Yvonne202202/MSc-Advanced-Project-Blog/README.md

# MSc Advanced Project Blog -The Clock of Life
<div align=center>
  
</div>

# Video Link：
https://vimeo.com/887942953?share=copy

## Project Brief
I once had a discussion the topic of death with my friends. Most of us feel some kind of fear when talk about death. This stems not only from the fear of the end of one's own life, but also from the pain of losing those close to them. Death often carries a heavy burden on people, so many people choose to avoid this sensitive topic, which also makes them feel helpless when they actually face death.

Therefore, I planned to do an interactive installation on the theme of "life and death," which would include some physics experiments. I hope viewers will come to a different understanding and thinking about death through this interactive installation.

## Ideation
### Research
Human's concept of life and death varies due to cultural, religious and other reasons.  Therefore, I think I need to understand people's views on death from a different perspective before I start the project.

People's perceptions of death are often influenced by their religious beliefs. Those with higher levels of religious belief had lower levels of death anxiety. They accept death in a more neutral way. In contrast, people with no religious affiliation were more likely to have death anxiety and positive attitudes about extending life.

In addition, the degree of death anxiety is also related to different regional cultures.

There are some taboos about death in East Asian cultures. For example, people sometimes avoid talking about death, especially on celebratory occasions. In addition, for traditional East Asians, especially Chinese, the same pronunciation as "death" is considered unlucky. For example, the word for the number "4" and "clock" in Chinese is pronounced the same as "death", so people should not give clocks or watches as gifts, and should also avoid giving things with a number of 4. Although many younger generations of East Asians are more open to these traditional taboos, the influence of such traditional thinking persists.

There are different attitudes towards death, even if there are certain differences among people from different cultural backgrounds, there are still some common points.
In every culture people mourn the dead. In a sense, people respect death, which is also a respect for life.

The famous philosopher Nietzsche once proposed "eternal reincarnation". He believed that the lives of dead individuals would reappear countless times in infinite time. The famous ancient Chinese philosopher Zhuangzi believed that death is another form of life, not the end of life, but the beginning of life.

In addition to discussing personal death, the death of someone close to you is also worth exploring in depth. In my research, I found that the death of a family member or friend is more difficult for many people to accept than their own death. They tend to avoid thinking about it, which caused some difficulties during my research. In order to clarify the research direction, I interviewed several participants. For one questionnaire, I designed a scenario: if a relative or friend is seriously ill and needs rescue, and the doctor tells the patient that he or she may not be able to live a normal life or even enter a vegetative state after rescue, will they still choose to continue rescue? Most respondents said it would be difficult for them to decide to give up on saving their loved ones unless the patient had previously made it clear that they did not want to be saved, even if the patient could still suffer. One interviewee even told me that she was afraid to face such a question. She didn't want to think about such a difficult choice ahead of time, which made it impossible for her to continue discussing the topic with me.

In the face of the death of another, people often suddenly experience a great sense of loss, which is difficult to accept and let go. After the loss of a loved one, it takes a long time for us to adjust and accept the loss. And, even after a long time has passed, we may not be able to fully let go. Certain scenes or things touch our heartstrings and remind us of them at certain moments, which make us ache and miss them. Therefore, how to achieve emotional relief is an important and in-depth issue.

I intend to explore life and death from a philosophical perspective through an interactive installation, and I will consider how to incorporate the sense of "finding closure" regarding the passing of a loved one.

In my work, I would like to show life and death as a never-ending cycle. "Life" is the beginning of the cycle, while "death" signifies its conclusion. However, with every ending comes a new beginning, and the chain of life continues.

### Concept Development

After conceptualizing the concept of the "circle of life," I encountered the challenge of how to concretize this "circle." I need to find a way to interact and engage the audience. Furthermore, I aim for this work to reach the viewers.

Under the suggestion from my supervisor Jen, I experimented with several different types of sensors and found some inspiration by studying the work of other artists. And I went to several material shops to explore if there was anything I could use.

I saw tools for making clocks for children in a shop, and it made me realize that I might be able to make a clock. The time on the clock is 0 o 'clock to 23:59 day after day, which is so similar to the cycle of life. What's more, "clock" sounds similar to the Chinese word "death", which has some symbolic meaning.

However, this clock needs to be different from a regular clock. I think it needs to be able to show the audience the process of life from birth to death, and then from death to birth again. And the interaction between the audience and the interactive installation is critical. The audience is in a sense part of this interactive installation that triggers the “circle of life”.

I considered creating a simulated heart on which the audience can perform CPR. This act initiates the “Circle of Life”, and each CPR attempt by the viewer is like a desperate bid to save a life.   However, all life has its endpoint, marking the inevitable completion of the circle of life. This conclusion does not signify the ultimate end, as every end heralds a new beginning. The intervals on the clock's dial can gradually decrease, simulating the journey towards “death”. At the inception of the “Circle of Life”, it is relatively easier for the audience to save this “life”. But as the hands of the clock edge closer to the endpoint, it races rapidly towards zero, symbolizing the inevitable and the futility in trying to rescue the “life”.

<div align=center>
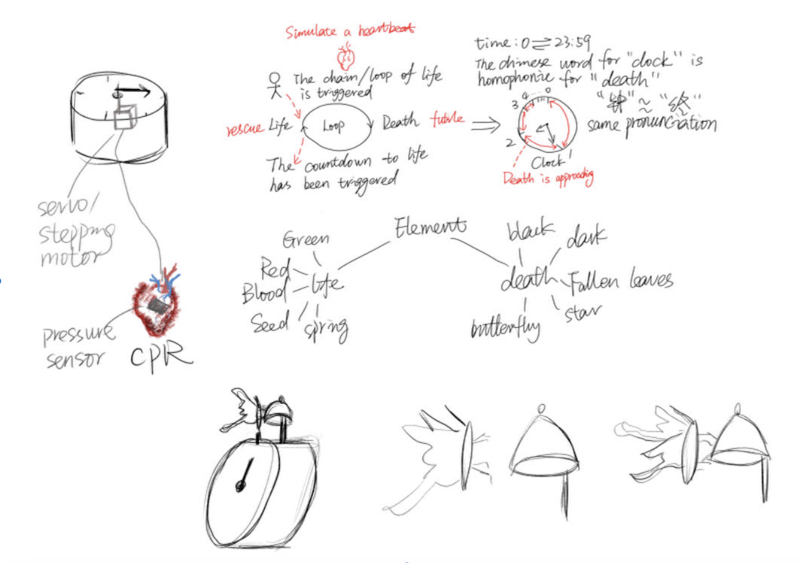
[picture p1: images/3.jpg]
  
</div>

However, the detailed design of the clock requires deeper consideration. In my initial search for inspiration, I considered elements that could symbolize life and death. To depict life, I thought of using vibrant green and red, with green representing life and red symbolizing blood. For representing death, I considered using black, dark tones, fallen leaves, stars, and butterflies.

<div align=center>
  
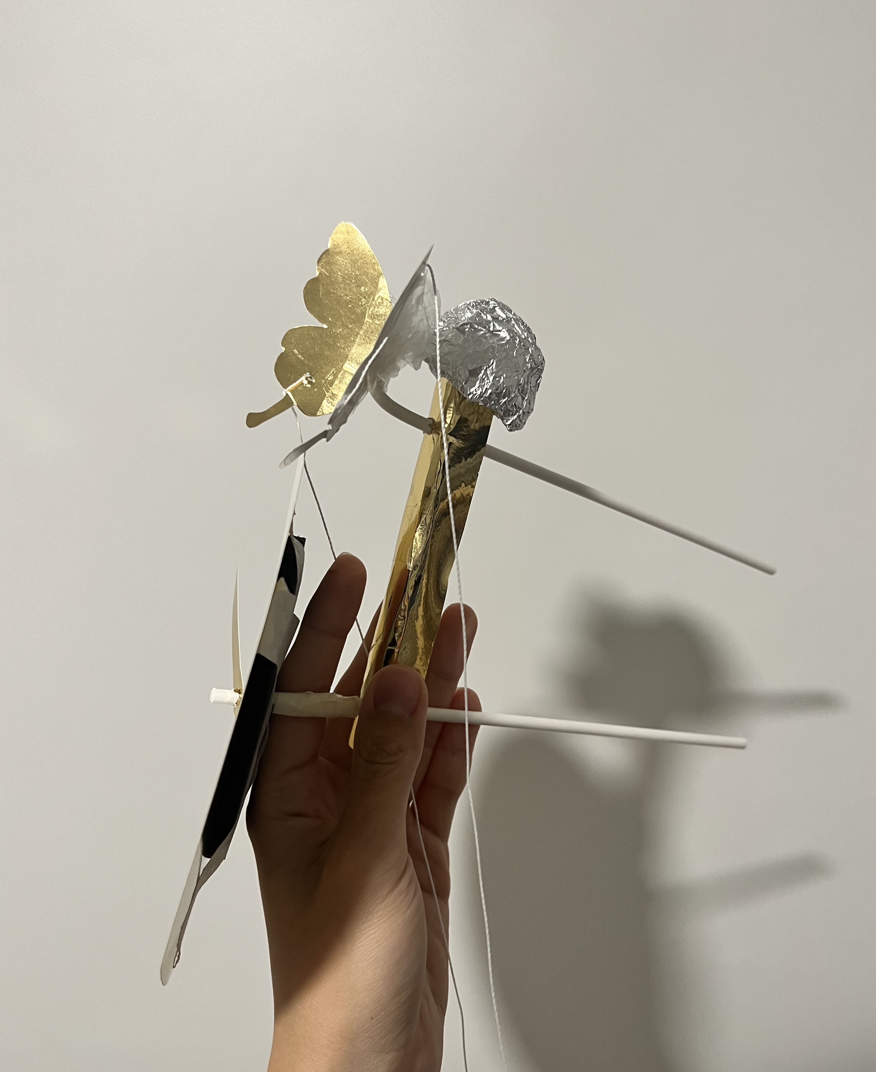
[picture p2: images/13.jpg]
  
</div>

For the first version of the prototype, I came up with the idea of using a mechanical butterfly as the bell of this clock, which rings the bell when time returns to zero. But after discussing it with Jen, my supervisor, I realized that I should focus more on the design of the clock face than the rest of it.

While designing the clock face, I came across some interesting materials while seeking inspiration. A paper-cut artwork captivated me.   Its creator had carved doves' shape from thick cardboard and took it outdoors, providing a unique view of the natural scenery through the cut-out shapes. Another source of inspiration was a drawing from the book 'The Ecological Relations of Roots' by John Ernest Weaver (1919), which illustrates a plant's root system but reminded me of human blood vessels.   This sparked an idea to merge the pattern of blood vessels with hollow carving, allowing viewers to observe life's pulsations through the "blood vessels". Similarly, this design could also represent tree roots, as both roots and blood vessels are symbols of life.

<div align=center>
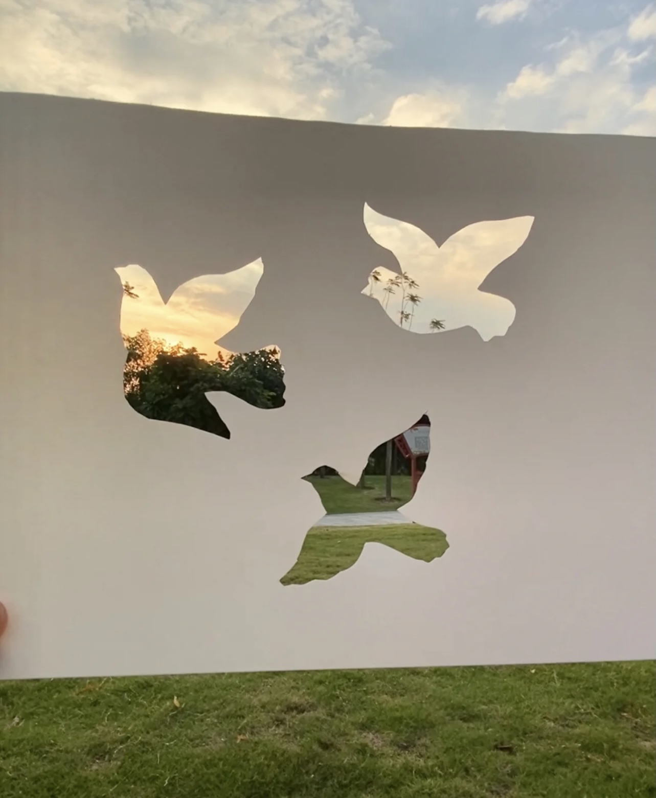
[picture p3: images/10.jpg]
  
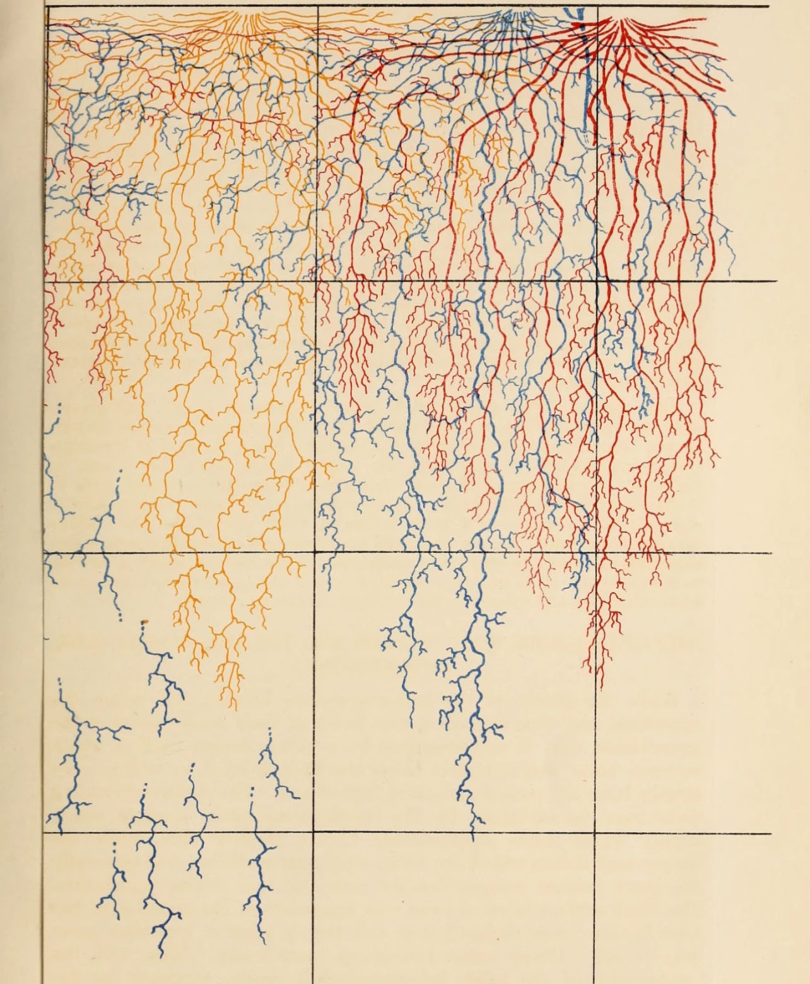
[picture p4: images/12.jpg]
  
</div>

I plan to make a clock face made of three superimposed coaxial discs. The topmost disc is transparent, engraved with time scales and remaining fixed. The second disc layer is made of opaque material with a blood vessel cutout design, allowing one to see through to the third layer. The bottom disc is made of colorful materials, representing life. I imagine that the second and third discs could be rotated according to the audience's interaction, such as through a heart rate sensor that detects the audience's heart rates and displays varying patterns based on the different readings.

<div align=center>
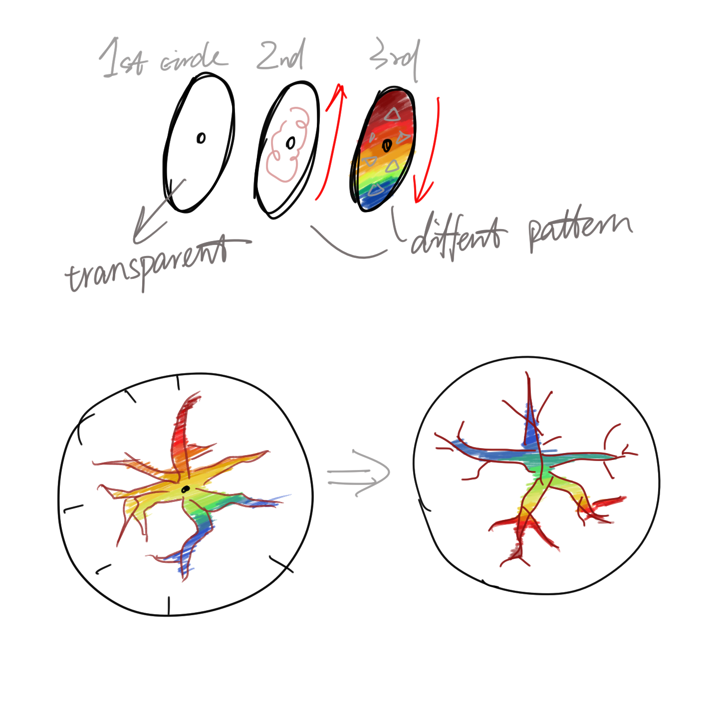
[picture p5: images/15.png]
  
</div>

<div align=center>
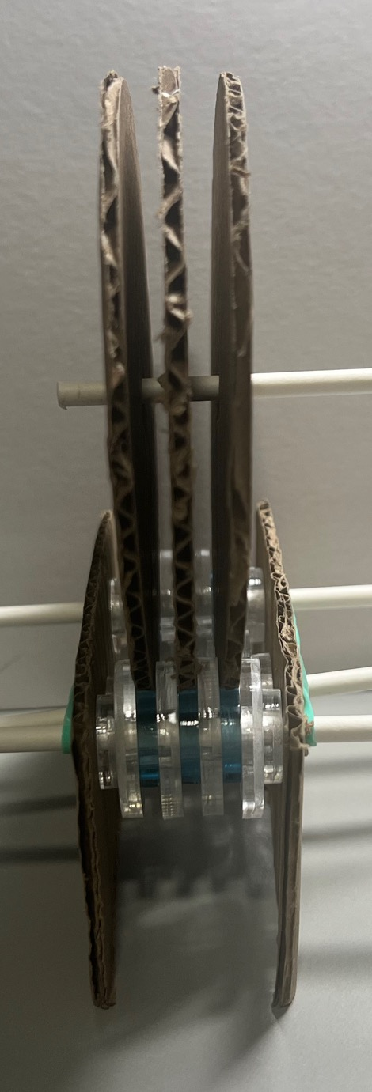
[picture p6: images/7.jpg]
  
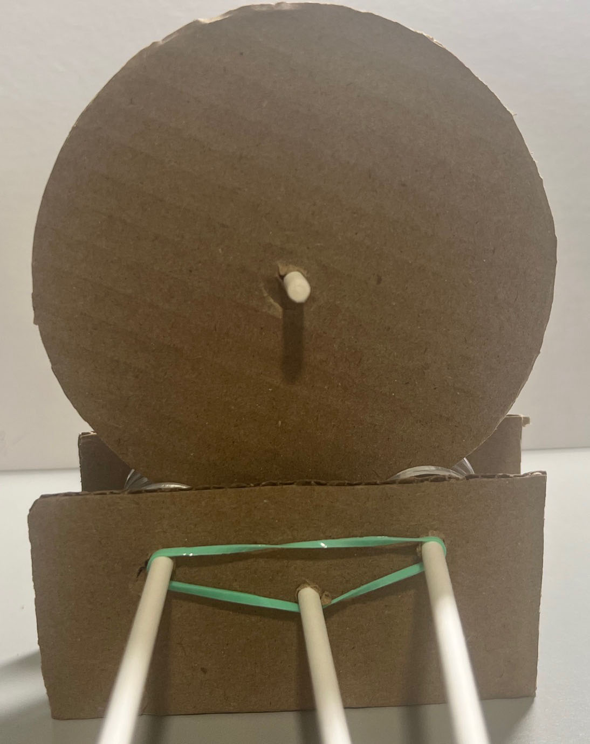
[picture p7: images/20.jpg]
  
</div>

### Determine Design Objectives

<div align=center>
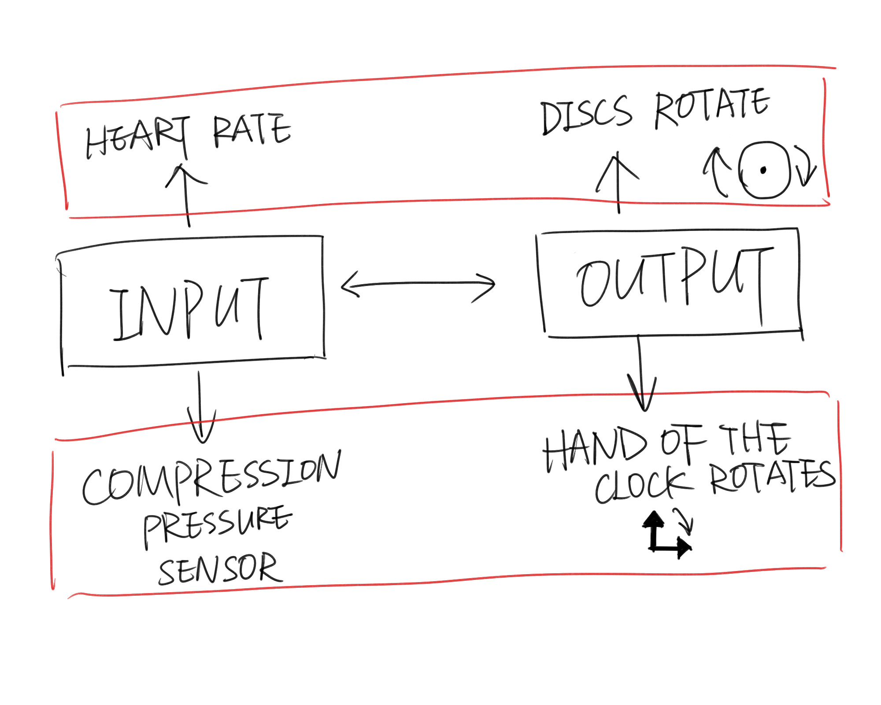
[picture p8: images/16.jpg]
  
</div>

My goal is to control two outputs with two inputs. The first input is the heart rate sensor. The sensor will be connected to the experiencer's finger, and when the sensor recognizes the different heart rates of different experiencers, it will control the rotation of the clock face disc, resulting in different heart rate patterns. The other sensor is the compression pressure sensor. It will be placed in a simulated heart, and the experiencer could perform "CPR" to control the rotation of the clock hand.

<div align=center>
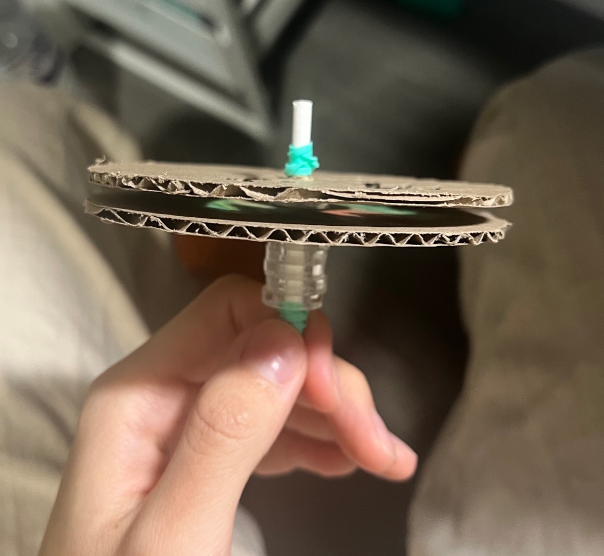
[picture p9: images/34.jpg]
  
</div>

My second prototype was made of three discs that were placed upright. I found it difficult to control the rotation of the three disks during the test. And I was planning to use acrylic as the material for my clock face. I think the load bearing and structure are also problems. After a round of iterations, I got my third version of the prototype. With this version in mind for load-bearing issues, I have removed the top disc from the previous version. And I considered placing the other two horizontally. After experimenting, I thought this version could be achieved.

I was going to use the compression pressure sensor to control the top clock face with blood vessel cutout design and the heart rate sensor to control the patterned bottom clock face.  The top clock face needs to reflect the passing of life to the experiencer.  So the effect I would like to achieve is that when the experiencer begins to "save" this "life", it is easy to move to the next scale, and gradually becomes more difficult.  So I want to control the twelve intervals of the clock of life to get smaller and smaller.  Therefore, I considered using a stepper motor to control the rotation Angle of the top clock face.  Due to the weight of the two layers of acrylic sheets, I considered using a DC motor with high torque to control the underlying clock face.

## Experimentation
### Test - Stepper Motor

<div align=center>
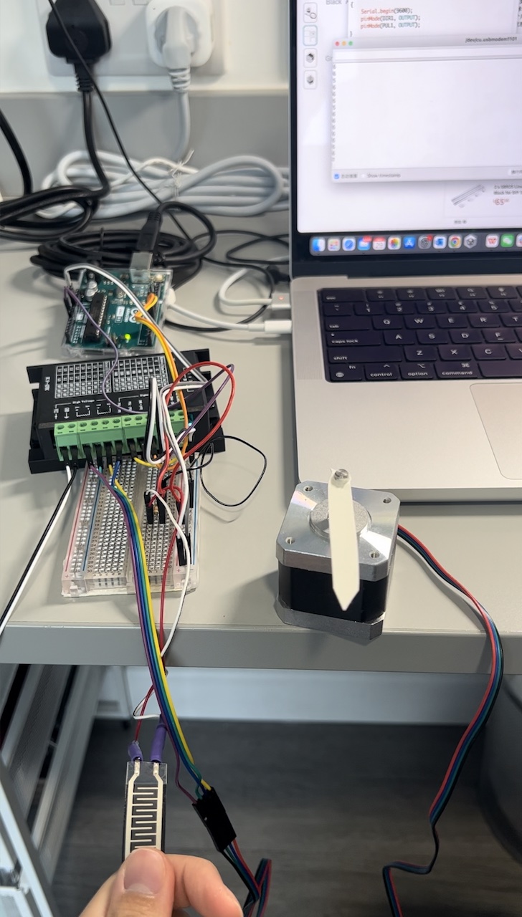
[picture p10: images/25.jpg]
  
</div>
The Arduino UNO board is used to read the status of the  compression pressure sensor. I have set the stepper motor's rotation angles to 95, 60, 45, 35, 30, 25, 20, 15, 12, 10, 8, and 5 degrees, and stored them in the array Step. I use a flag and the pressure reading together as the judgment conditions. If the pressure is greater than 1 and the flag is set to true, the stepper motor is activated and operates according to the corresponding number of steps in the array Step, until the pressure is released and no longer applied. When the count exceeds 12, it is reset to 1, thereby cycling through the values in the array Step.
<div align=center>
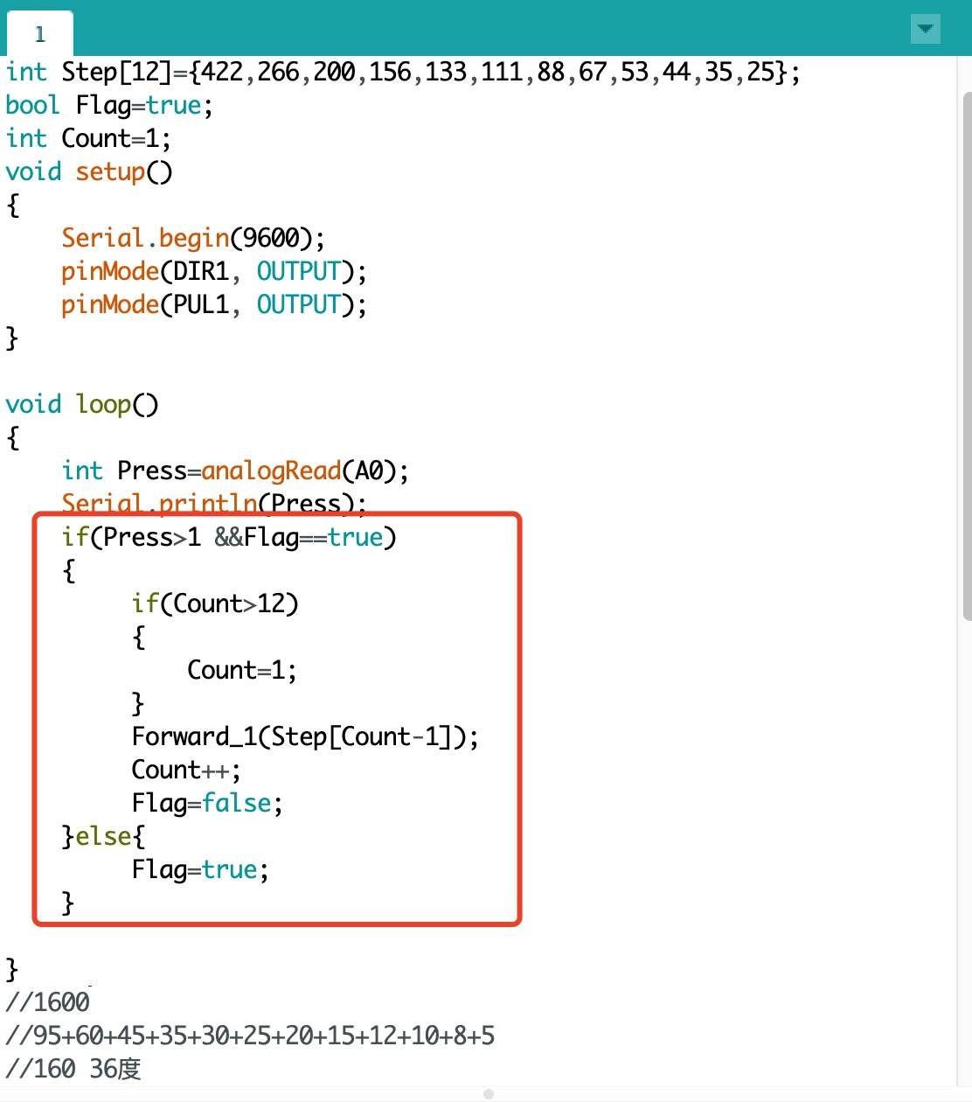
[picture p11: images/49.jpg]
  
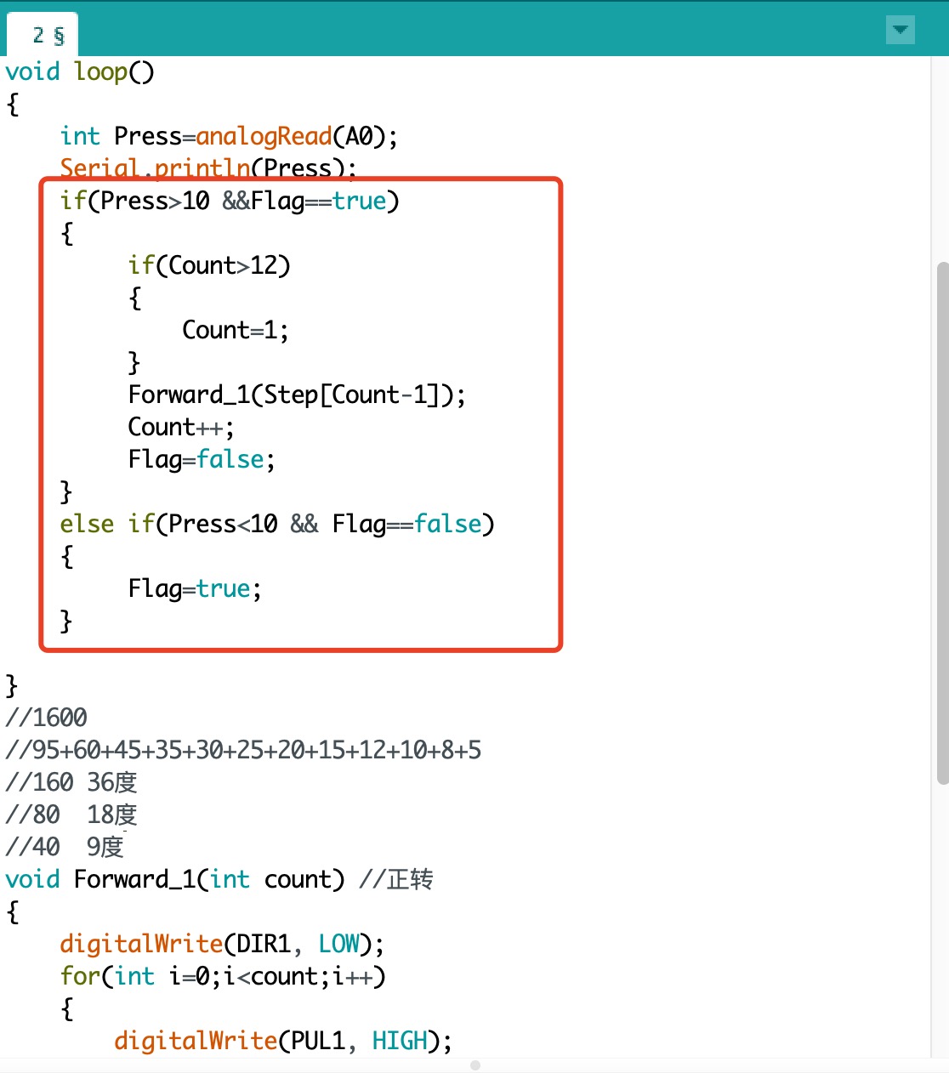
[picture p12: images/50.jpg]
  
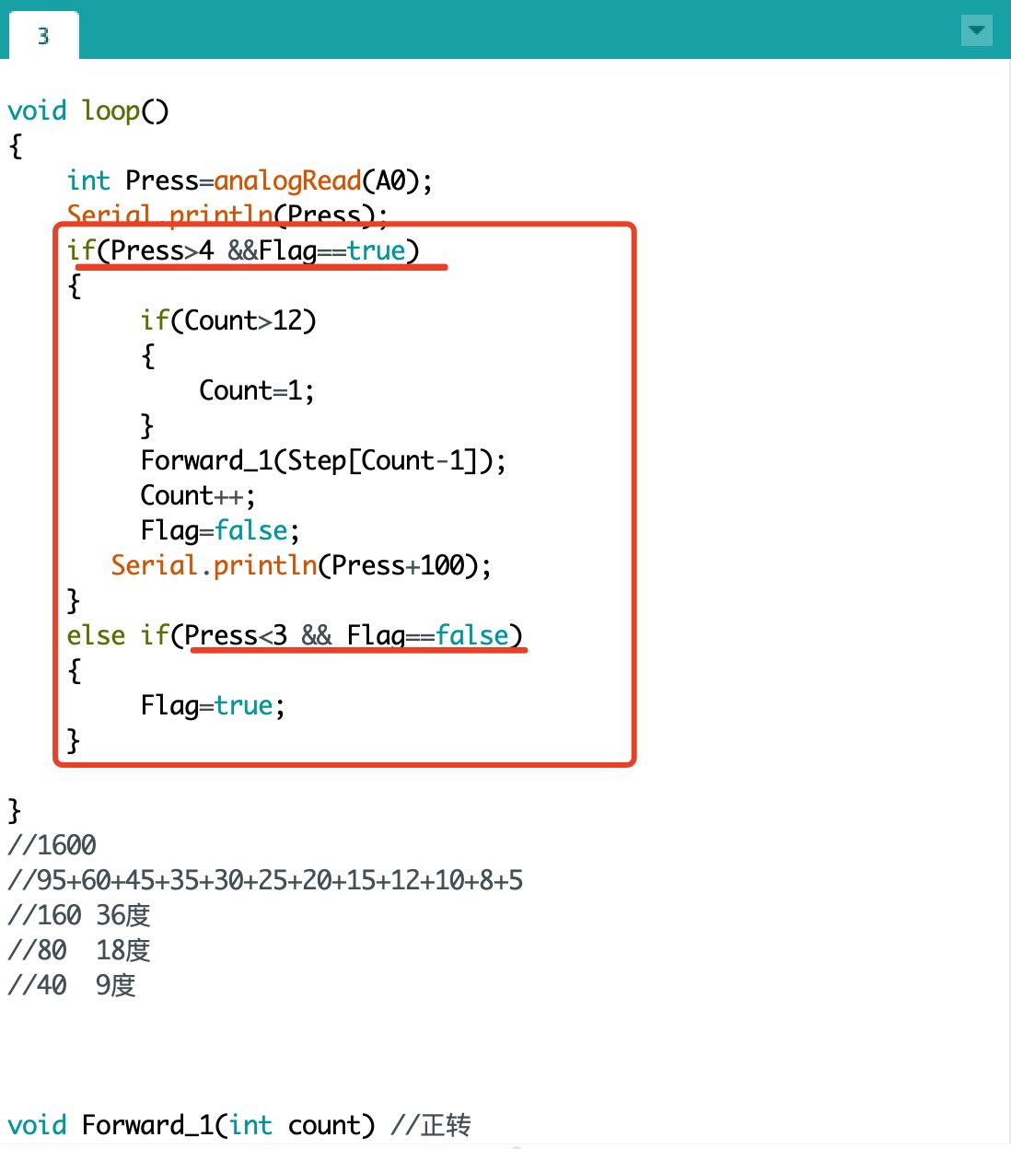
[picture p13: images/51.jpg]
  
</div>

The initial version of the code did not achieve the effect I desired. During testing, if I continuously pressed the pressure sensor without releasing it, the stepper motor kept running continuously, instead of waiting for me to release and then press again for the next operation. I want to simulate the effect of cardiopulmonary resuscitation (CPR), so it is necessary for the stepper motor to execute once with each press.

However, through monitoring the serial port, I discovered that even with continuous pressure, the detected pressure values fluctuated. I attempted to achieve the desired effect by adjusting the pressure threshold. I set it so that if the pressure is greater than 4, the stepper motor activates, and if it's less than 3, it doesn't move. For values between 3 and 4, it maintains the previous state. This adjustment resulted in the effect I was looking for.

### Test - Heart Rate Sensor

<div align=center>
  
  
</div>

I used the MAX30102 heart rate sensor module to read heart rate data in real time. By applying the map function, I converted the heart rate values (BPM) into a range appropriate for PWM output, which in turn enabled the control of the DC motor's rotation. Individually testing the pressure sensor and the heart rate sensor presented no issues. However, occasional difficulties arose in controlling the DC motor when I attempted to merge the code for both sensors.The DC motor frequently operated in an erratic manner. I turned to ChatGPT for assistance, and it was pointed out that the erratic behavior might stem from signal interference between the two sensors or from potential logical clashes within the program when handling inputs from both sensors. Since Arduino programs are typically single-threaded, handling multiple tasks such as reading sensor data and controlling motors can lead to conflicts in timing. I tried avoiding the use of the delay() function, but it still did not achieve the effect I got when testing both motors separately. Eventually, I used two separate Arduino boards to control each module.
<div align=center>
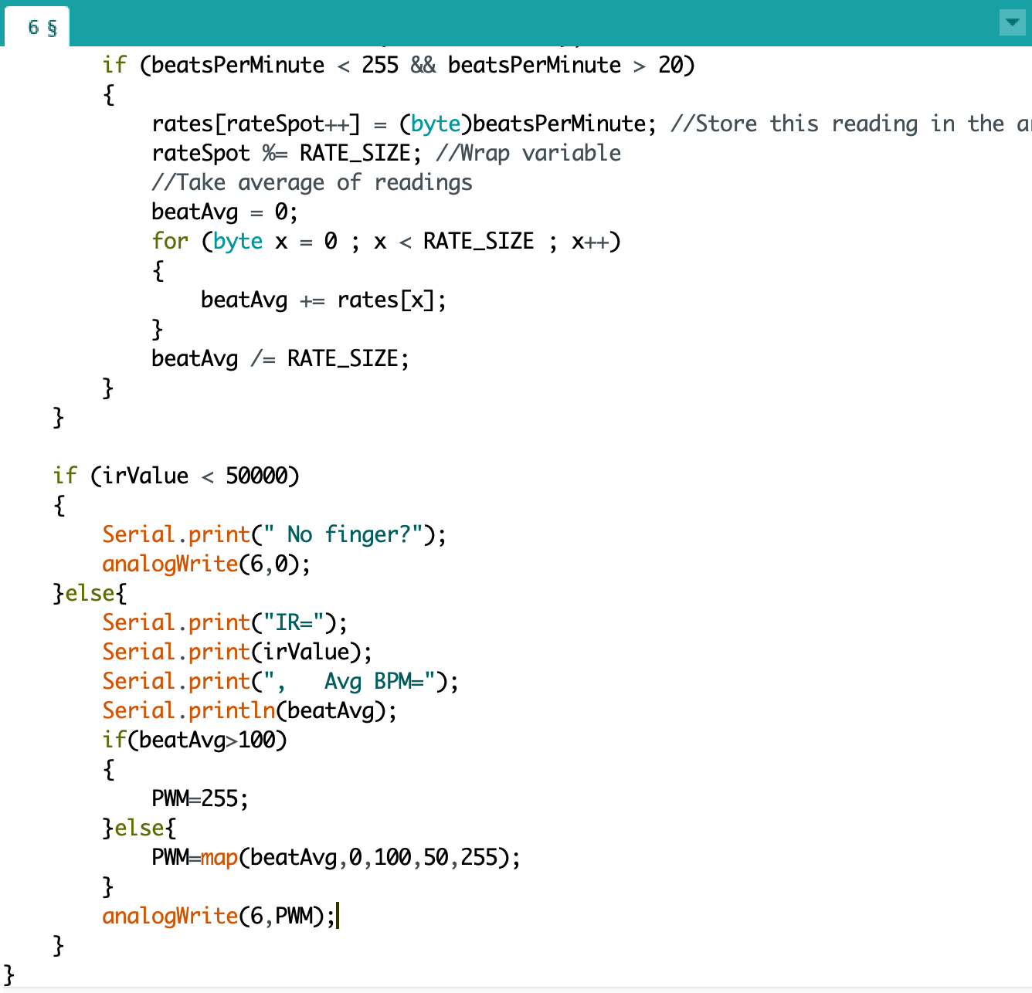
[picture p15: images/59.png]
  
</div>

### Laser Cutting

<div align=center>
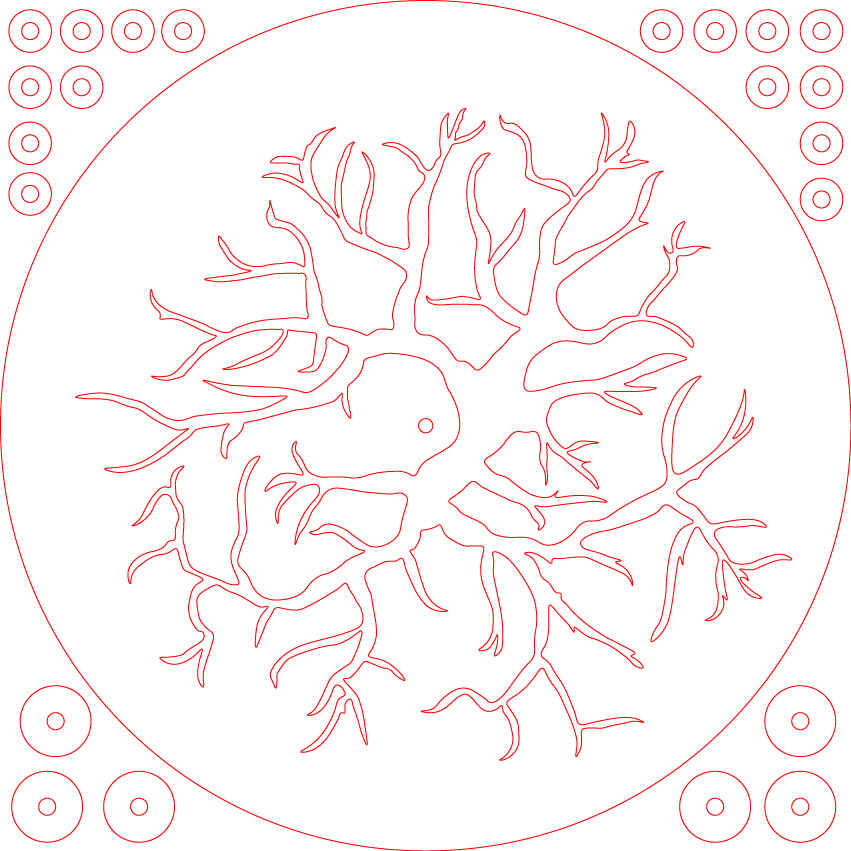
[picture p16: images/21.jpg]
  
  
</div>

<div align=center>
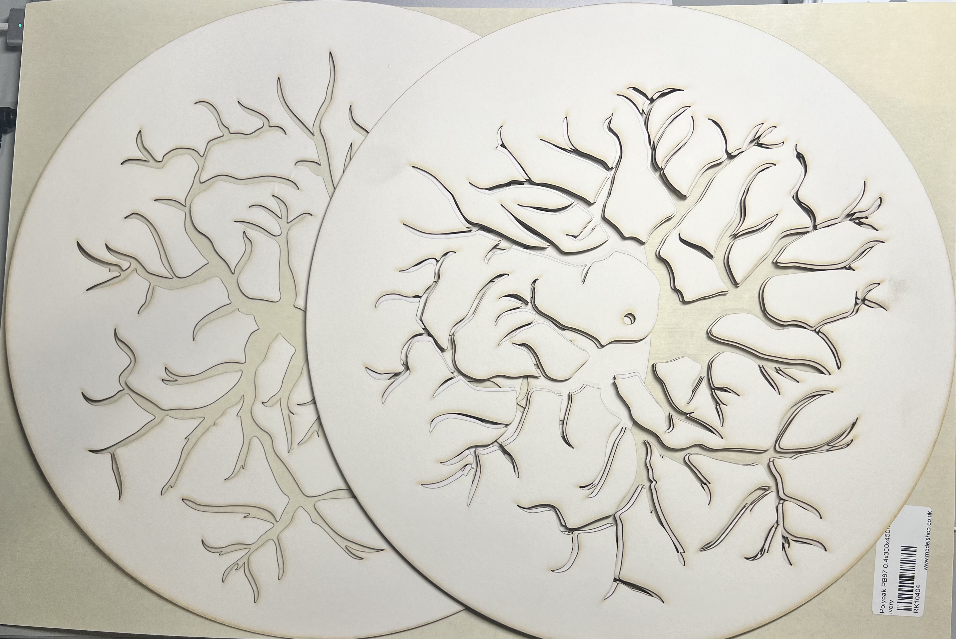
[picture p17: images/26.jpg]
  
</div>

I used illustrator to design patterns requiring laser cutting and booked a laser cutting workshop at CCI. I finally successfully completed the laser cutting under the guidance of Chris. I used acrylic sheet to cut out the bottom clock face, and used white thick cardboard to cut out the upper clock face with a blood vessel pattern. In addition, I also cut a transparent disk of equal radius to support the cardboard and some small disks to separate the two clock faces.

## Mechanical Design

I need to control the top clock face through the stepper motor and the bottom clock face through the DC motor. The two clock faces are coaxial. I thought I could put the upper and lower layers through the shaft of the stepper motor. I need to make the top layer fixed to the stepper motor shaft and the bottom layer not fixed. Then I can make the top clock face rotate with the shaft of the stepper motor.
<div align=center>
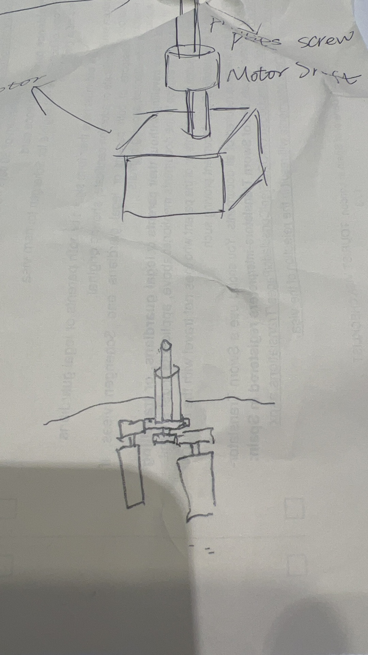
[picture p18: images/35.jpg]
  
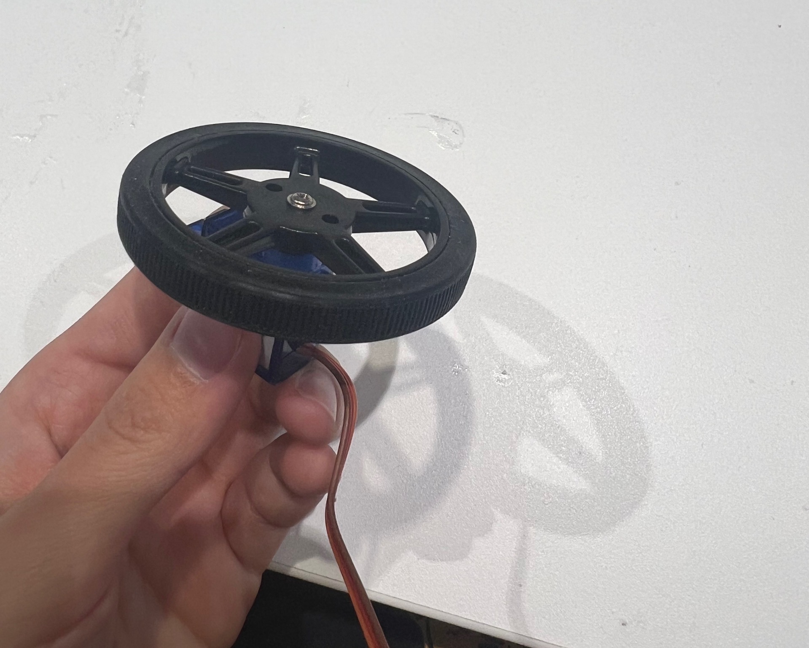
[picture p19: images/36.jpg]
  
</div>
I had trouble controlling the rotation of the underlying clock face, so I booked the tutorial and asked Matt for advice. Matt introduced me to the internal structure of the clock and recommended the wheels for servo, which provided me with inspiration. I thought I could use gears or synchro wheels. 
<div align=center>
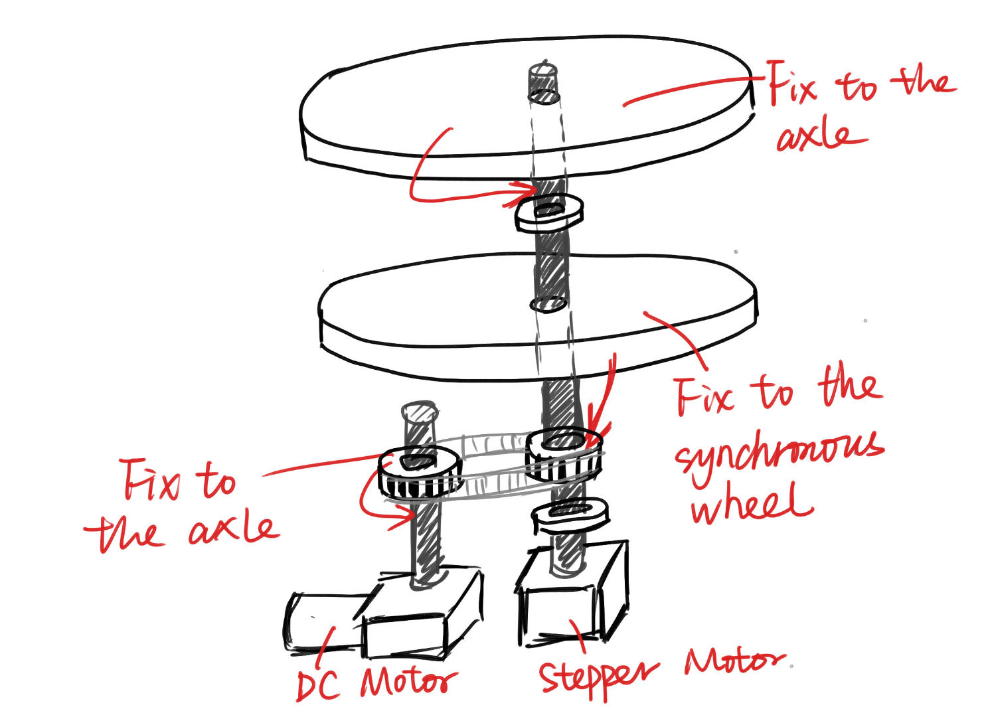
[picture p20: images/42.jpg]
  
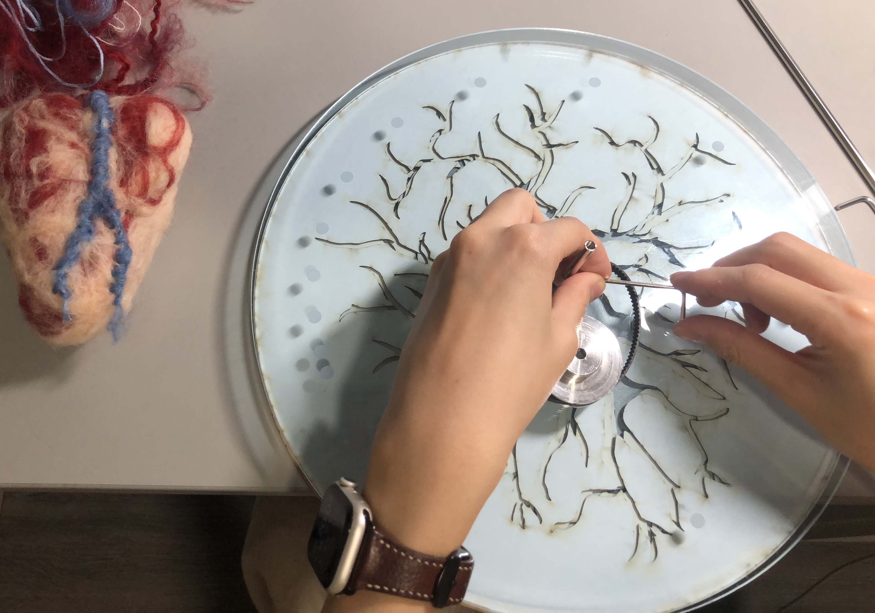
[picture p21: images/28.jpg]
  
</div>
I fixed the synchronous wheel used to control the rotation of the belt on the rotating shaft of DC motor, and fixed the bottom clock face with the controlled synchronous wheel. In this way, when the DC motor starts to work, the synchronous wheel on the DC motor rotating shaft will also rotate synchronously with the shaft, so as to control the rotation of the bottom clock face through the pulley.

<div align=center>
  
  
</div>
<div align=center>
  
  
</div>
The shaft of the stepper motor and the DC motor was not long enough, so I needed to extend their shaft. I use a coupling to achieve this effect.

## Appearance Optimization
I used some colored beads and sequins to create the pattern of the underlying clock face.<div align=center>
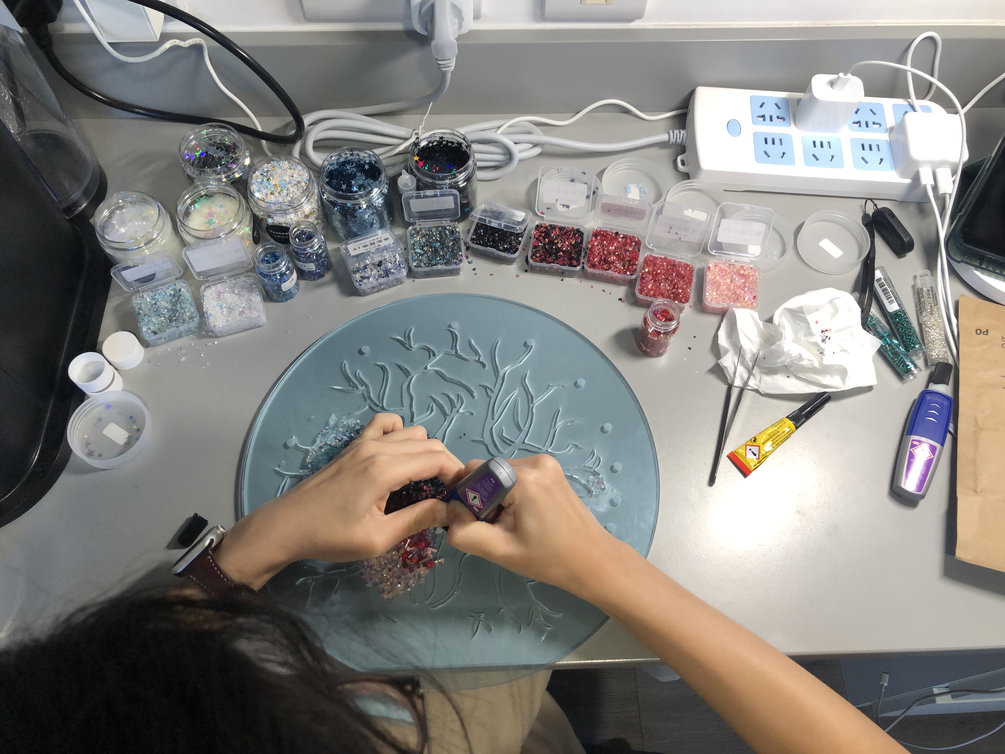
[picture p22: images/43.jpg]
  
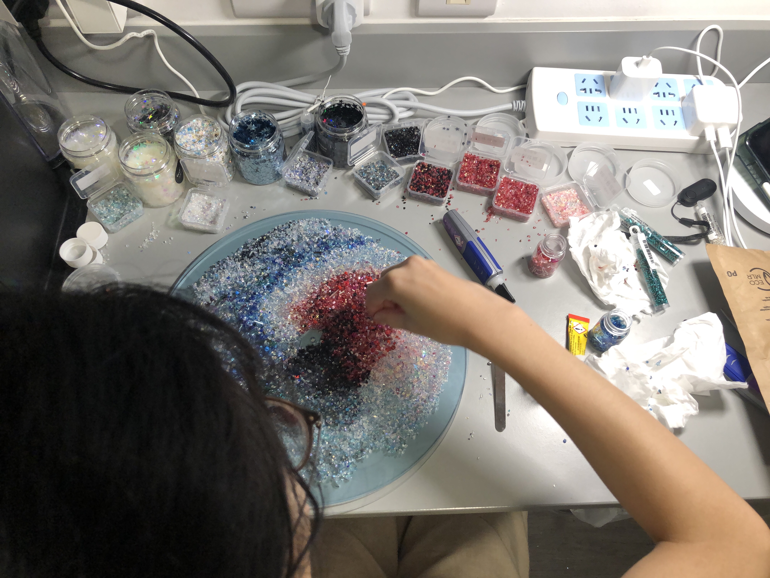
[picture p23: images/44.jpg]
  
</div>
I layered the two clock faces on top of each other after completion. However, I noticed that the opacity of the top layer impaired the light transmission, making it difficult to see the colored patterns on the bottom layer through the hollow, even in a well-lit room.
<div align=center>
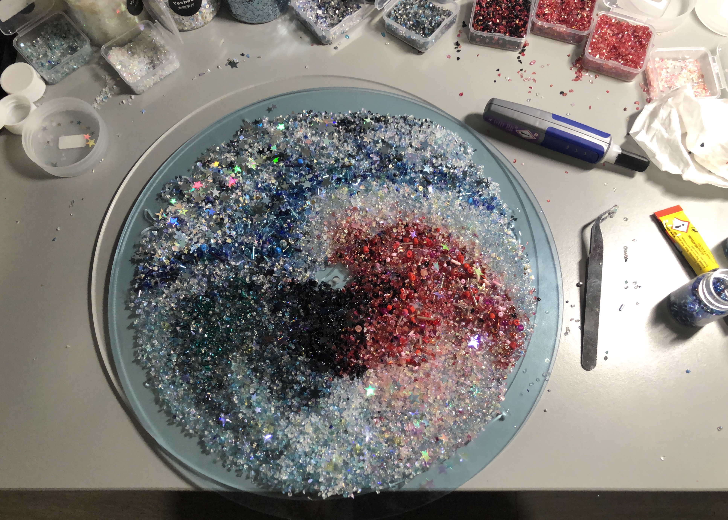
[picture p24: images/29.jpg]
  
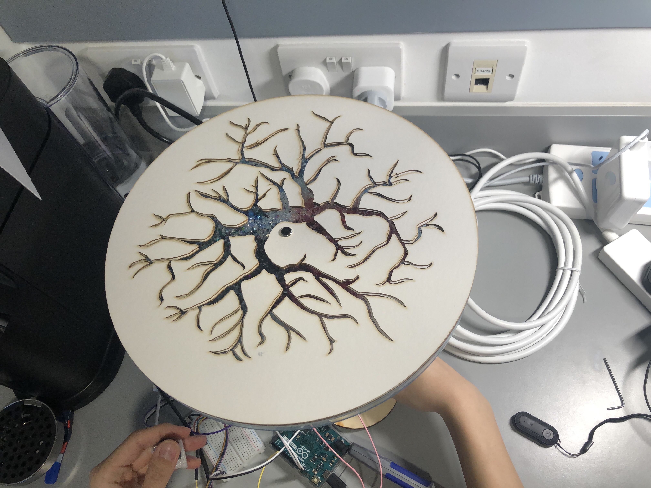
[picture p25: images/45.jpg]
  
</div>

<div align=center>
    
</div>
In order to better see the pattern on the surface, I placed an LED light on the shaft of the DC motor. I need to extend it a little bit along the axis so that the light source is not in a fixed position. In addition, I need to make sure that its placement will not be affected by the stepper motor.
<div align=center>
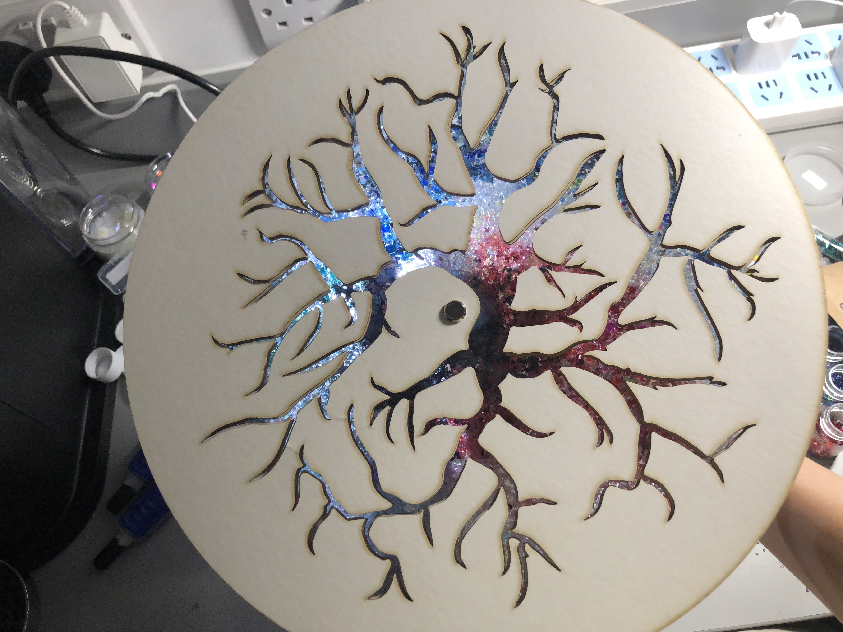
[picture p26: images/30.jpg]
    
</div>

I chose felting Wool and yarn to make the artificial heart. The compression pressure sensor will be placed inside the simulated heart. In order to ensure that the data it reads is not affected, I need the simulated heart to be light and soft. These two materials meet this requirement. They are easy to shape, light, and come in a variety of colors. And yarn can create the effect of blood vessels.

<div align=center>
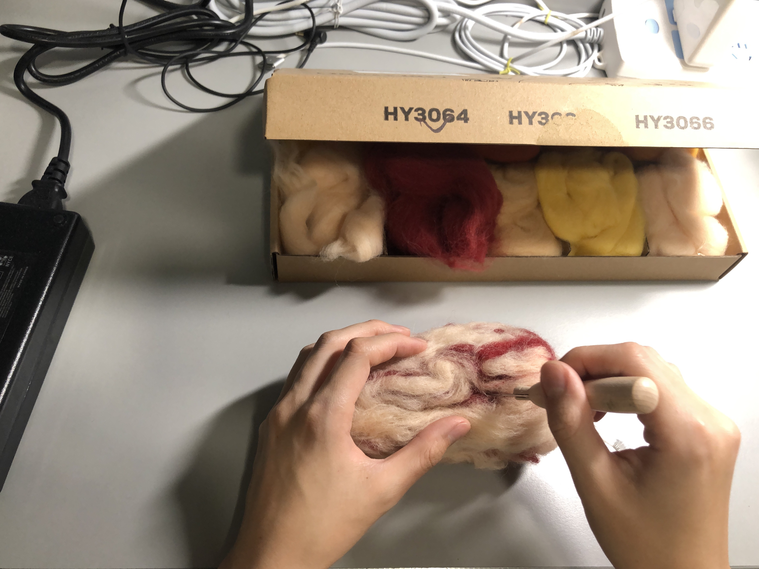
[picture p27: images/32.jpg]
  
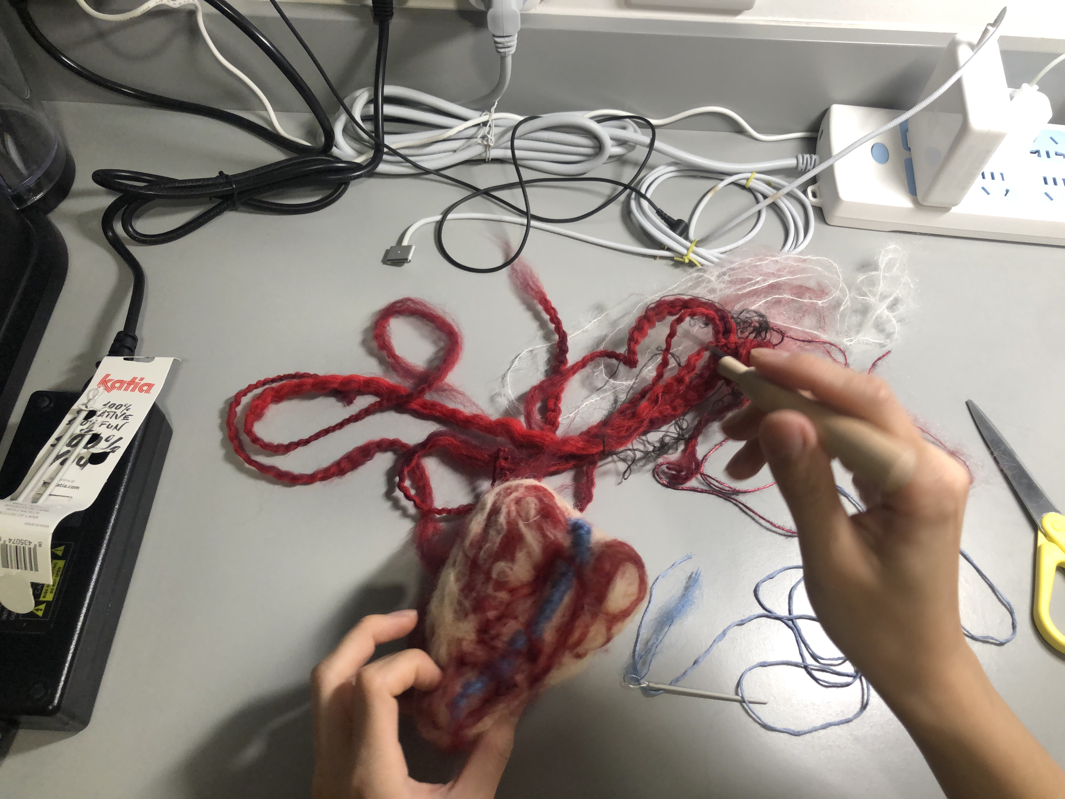
[picture p28: images/46.jpg]
  
</div>

<div align=center>
  
  
</div>

## Final Test
<div align=center>
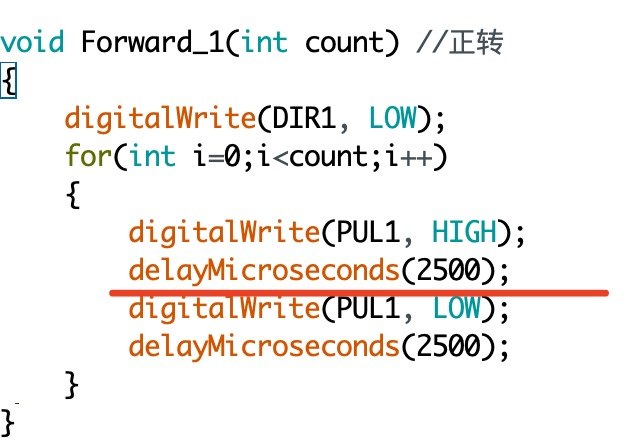
[picture p29: images/52.jpg]
  
  
</div>

During the final testing, I observed that the upper layer of the clock face exhibited significant shaking while rotating, as if it was being affected by inertia. At first, I thought it was due to the motor not being securely mounted. However, a closer inspection after dismantling revealed that this was not the problem. After conducting numerous tests, I found that reducing the speed of the stepper motor mitigated the issue.

## Final Product

<div align=center>
  
  
</div>
<div align=center>
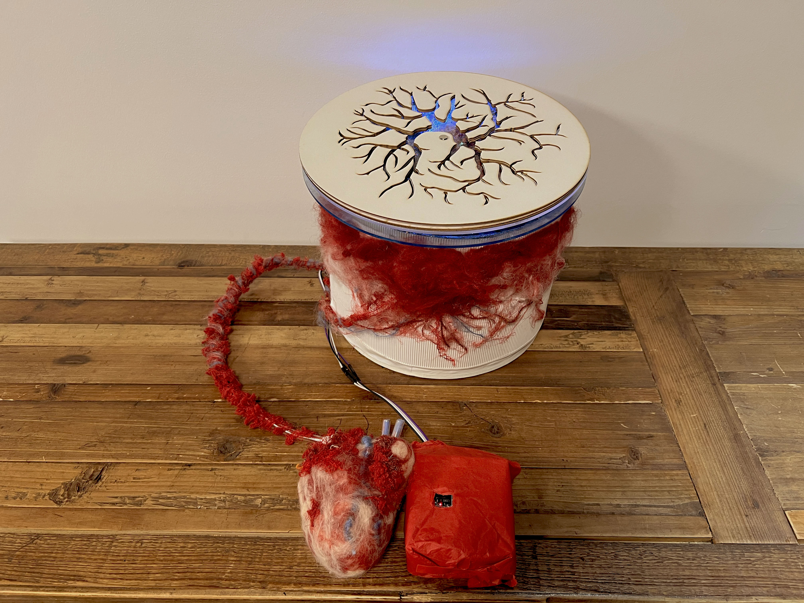
[picture p30: images/66.jpg]
  
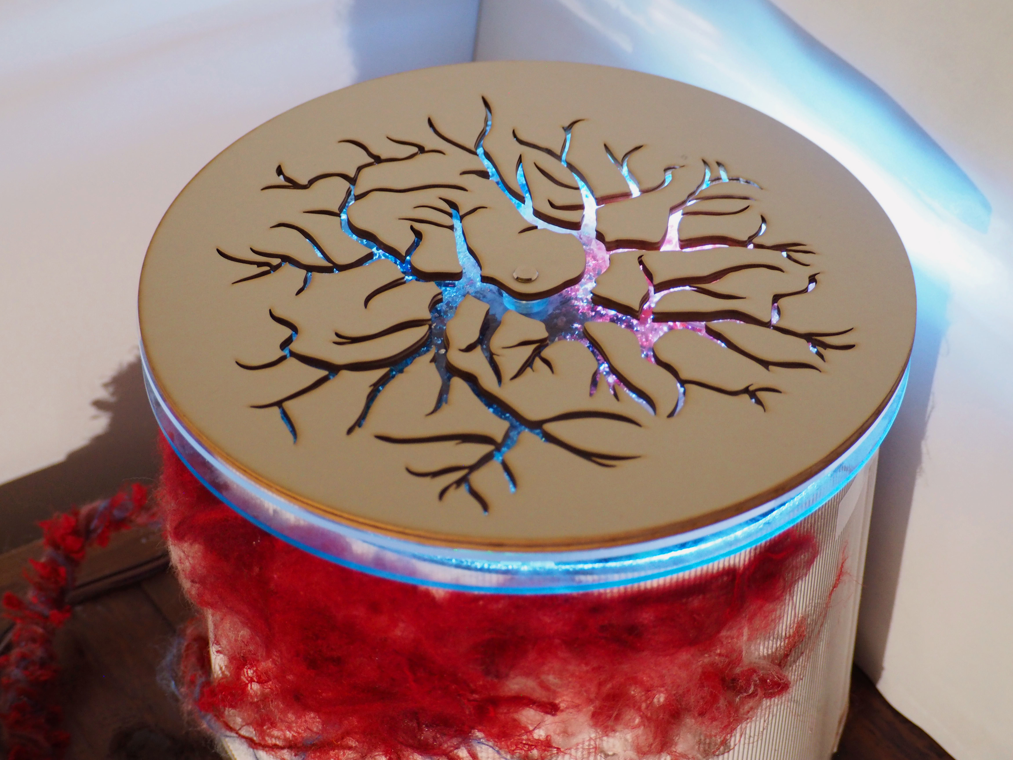
[picture p31: images/67.jpg]
  
</div>

## User Experience

<div align=center>
  
  
</div>

I invited two users to participate in the user experience and collected their feedback. Participant A had a general understanding of the subject of this interactive installation before experiencing it, while Participant B experienced it without knowing what the artwork was intended to convey.

During the experience, Participant A made a depleted object come to life by constantly pressing the simulated heart. She found that the Angle of rotation of the round board varied during the pressing process. The top round board was in a static state without pressing on the heart, and she felt that it had lost its life. After she touched the red box, she thought that the change of light and shadow in this installation reminded her of the blooming of life.

Participant B was associated with life because of the heart on the installation and thought that pressing the heart seemed to create heartbeat and revive life. As the Angle of rotation of the round board gradually decreased, she felt that her life was coming to an end. She likens the installation to a tree that has been cut down and is being revived.

## Future Work

Before installing the LED lights onto the DC motor, I manually simulated the effect using my phone's flashlight. To my surprise, I found that when the light source was strong enough and rotated around the clock's axis, it created an effect similar to a sundial. Sundials were ancient devices used to tell the time of day based on the sun's position, essentially serving as ancient timekeeping tools. The principle involves using the sun's shadow direction to determine and divide time. My original plan was to install LEDs to achieve this effect. However, due to the rotational axes of the two servos interfering with each other, I have not yet been able to make the light source move around the clock face with a larger radius. I believe I can continue to research this structure to achieve a 'sundial' effect. This would also make the interactive installation more aligned with the theme of "The Clock of Life".
<div align=center>
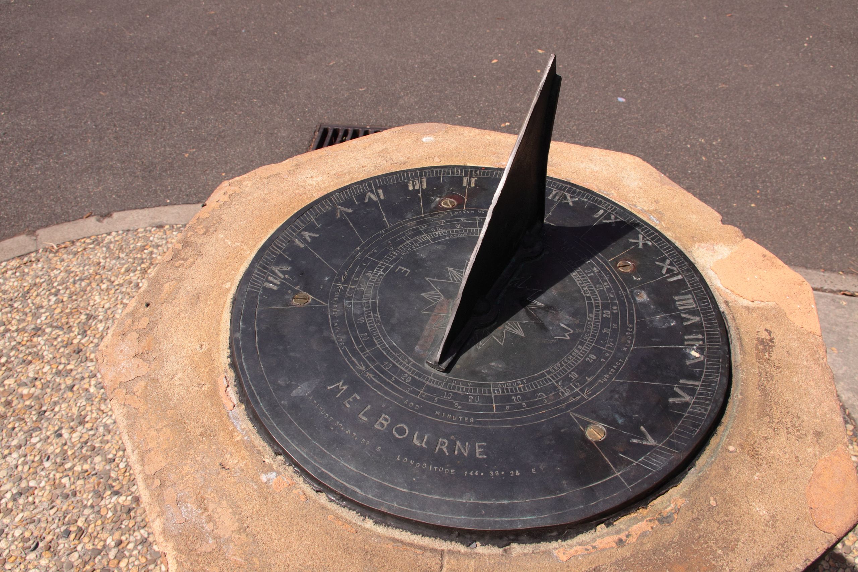
[picture p32: images/54.jpg]
  
  
</div>
