Yvonne202202/MSc-Advanced-Project-Blog/images/6.pic.jpg

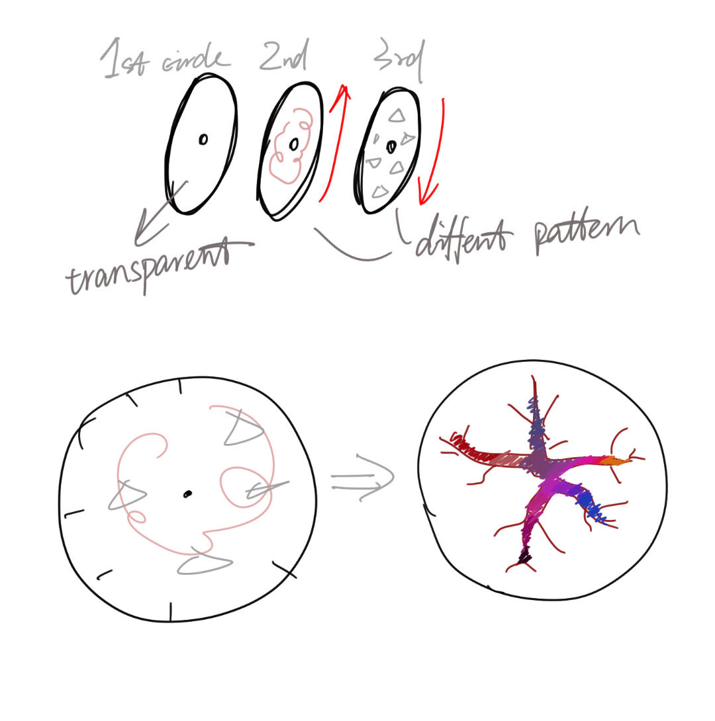
images/6.pic.jpg
