Yvonne202202/MSc-Advanced-Project-Blog/images/9.jpg

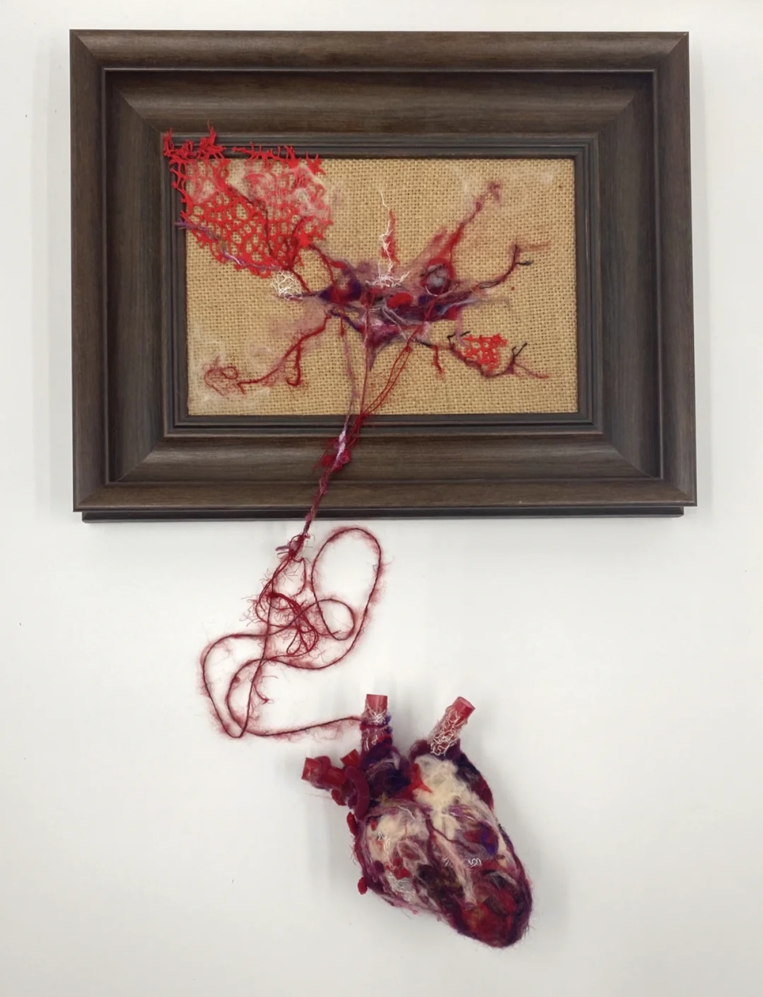
images/9.jpg
