Yvonne202202/MSc-Advanced-Project-Blog/images/18.JPG

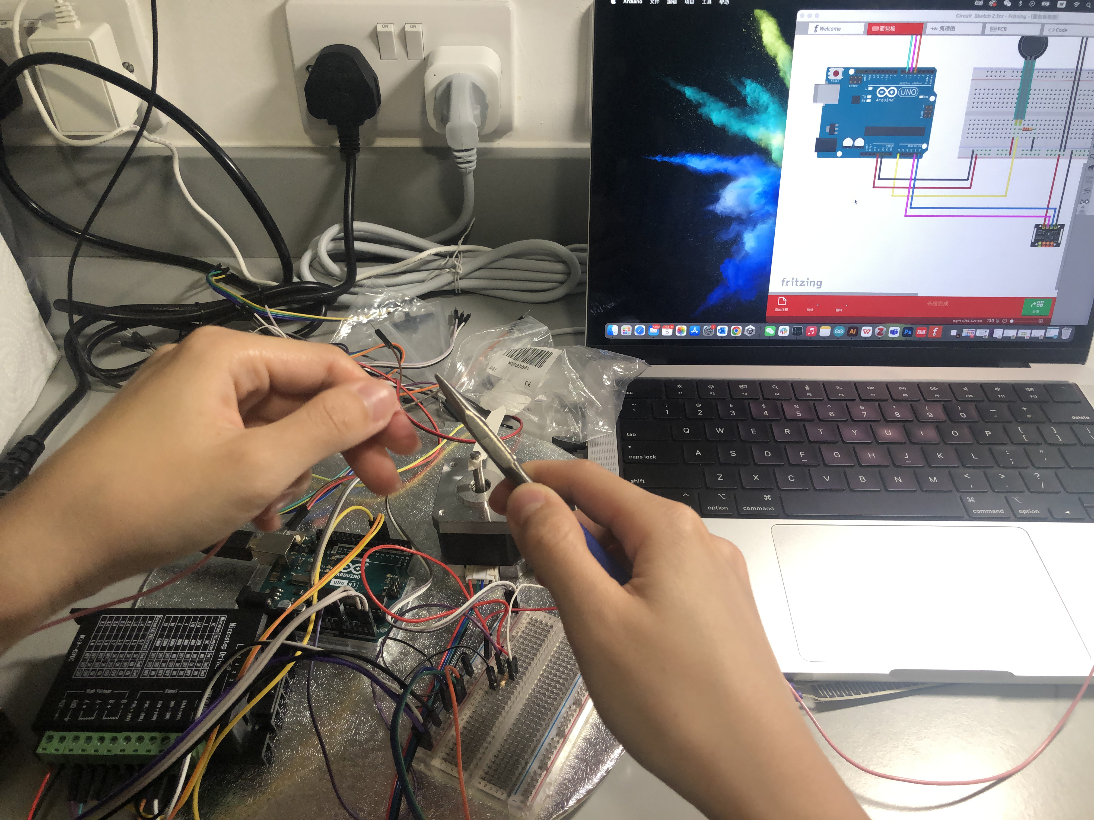
images/18.JPG
