Yvonne202202/MSc-Advanced-Project-Blog/images/33.jpg

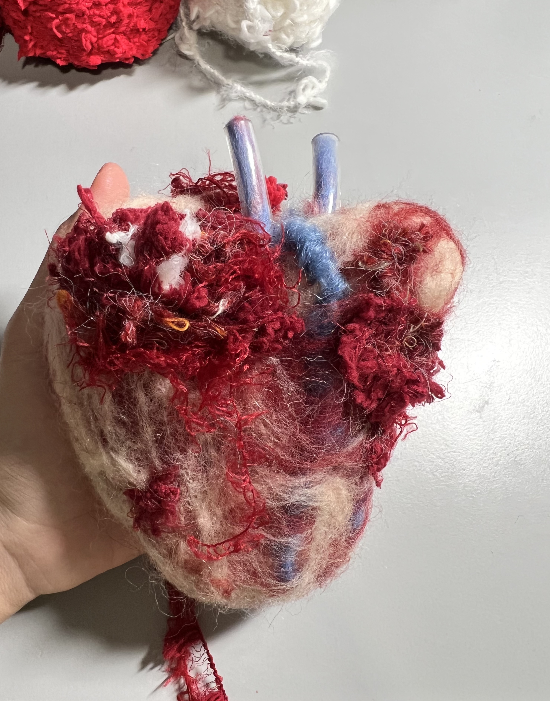
images/33.jpg
