Yvonne202202/MSc-Advanced-Project-Blog/images/55.jpg

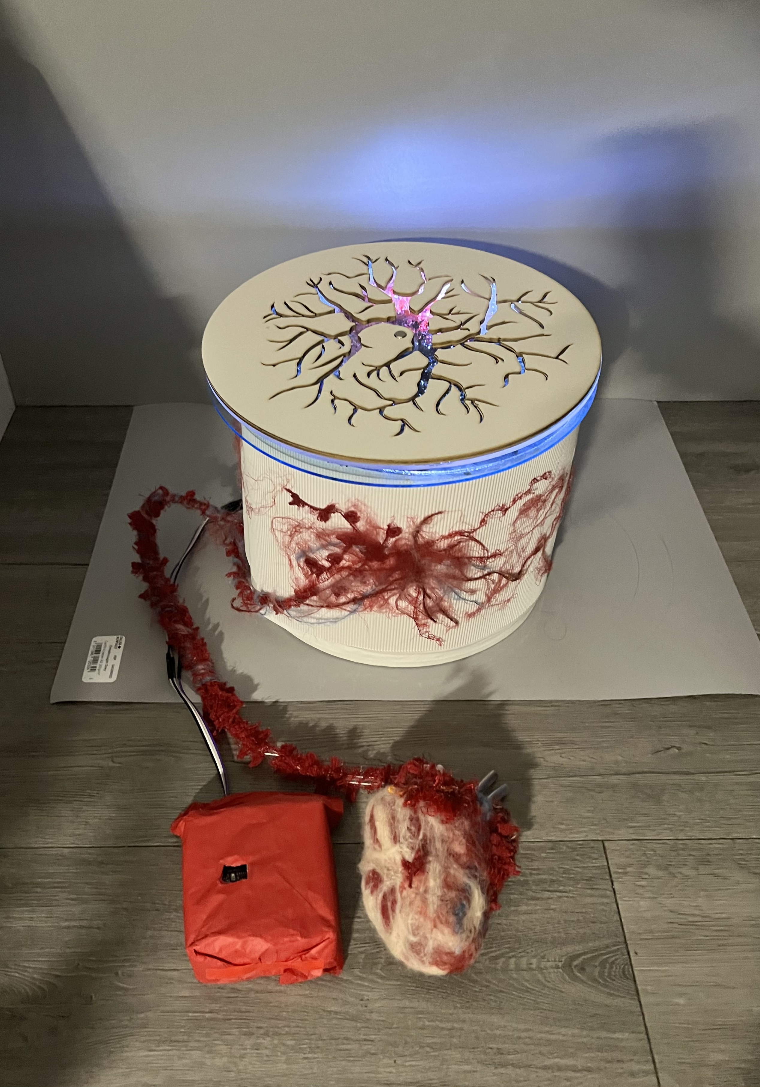
images/55.jpg
