Yvonne202202/MSc-Advanced-Project-Blog/images/56.jpg

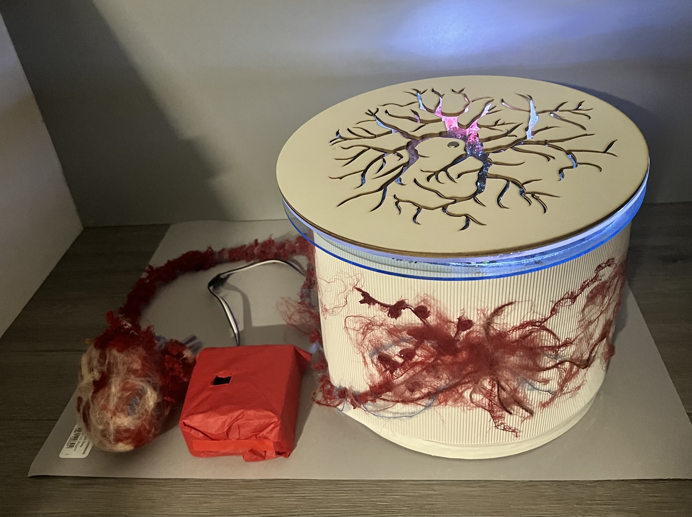
images/56.jpg
