Yvonne202202/MSc-Advanced-Project-Blog/images/57.jpg

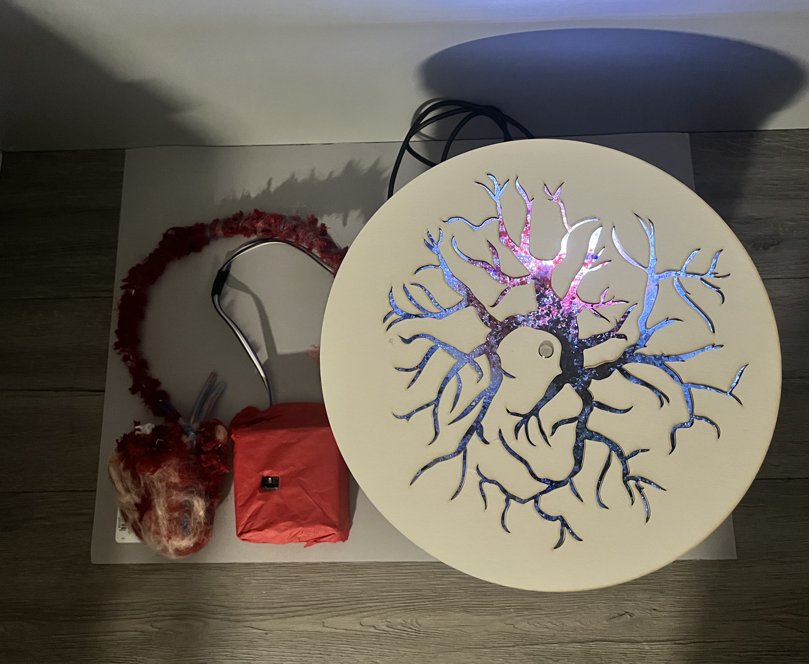
images/57.jpg
