Yvonne202202/MSc-Advanced-Project-Blog/images/58.jpg

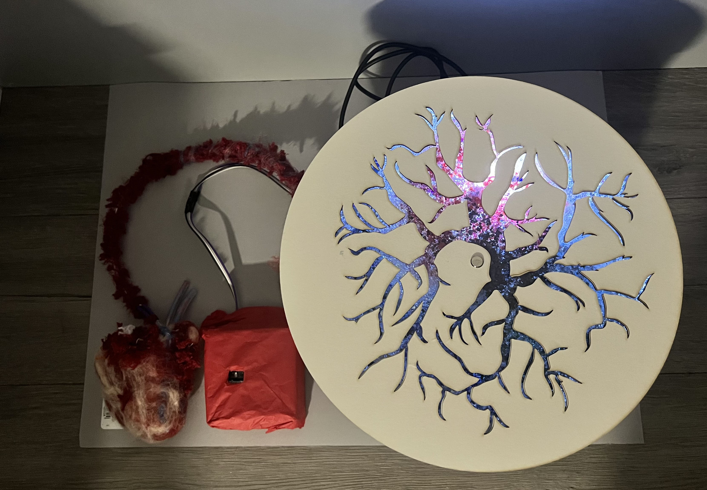
images/58.jpg
