Yvonne202202/MSc-Advanced-Project-Blog/images/27.jpg

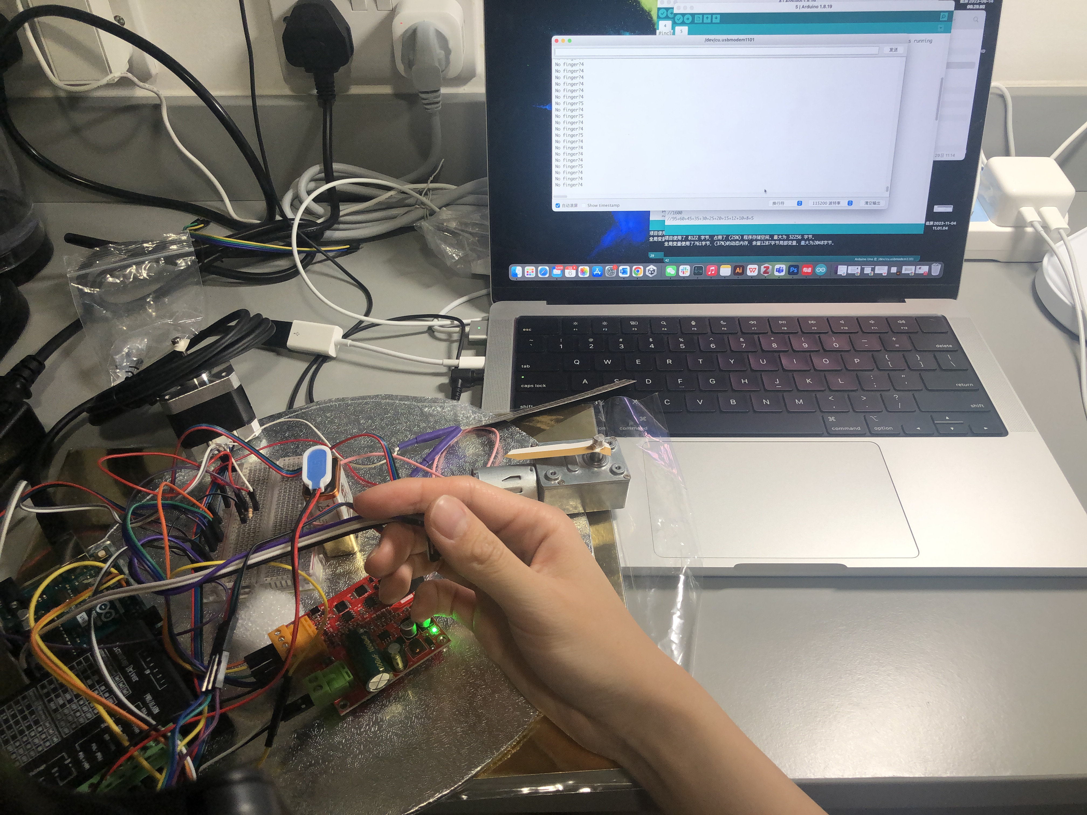
[picture p14: images/27.jpg]
images/27.jpg
